BG4RFF/Pixie3/11_external_lpf.gif

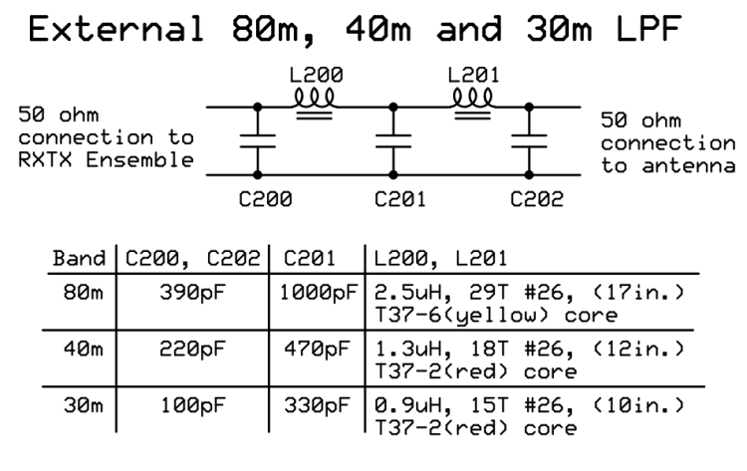
11_external_lpf.gif
