BG4RFF/Pixie3/pixie2-schematic.gif

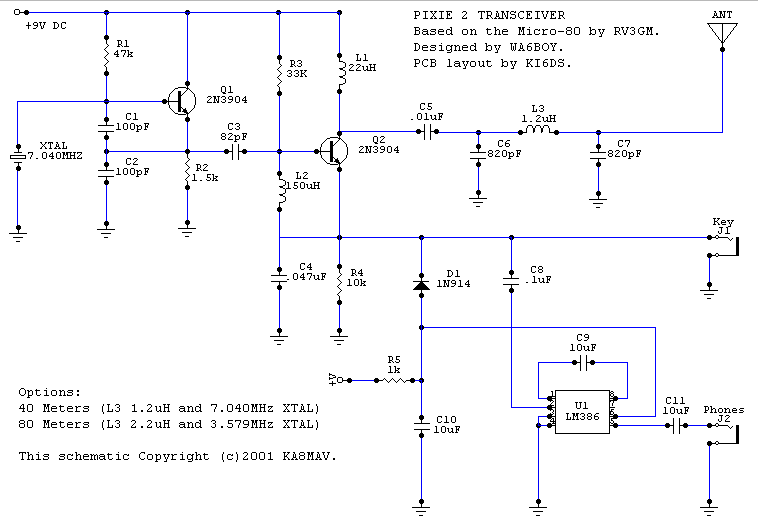
pixie2-schematic.gif
