BG4RFF/Pixie3/(notices)

Notices in the files:
radiono/radiono.ino:
under the terms of the GNU General Public License as published by the Free
